ObliviousGmn/VoronUsers/printer_mods/bobbleheed/Magnetic_Panels/STL/Magnectic_MidMount_4mm.3mf

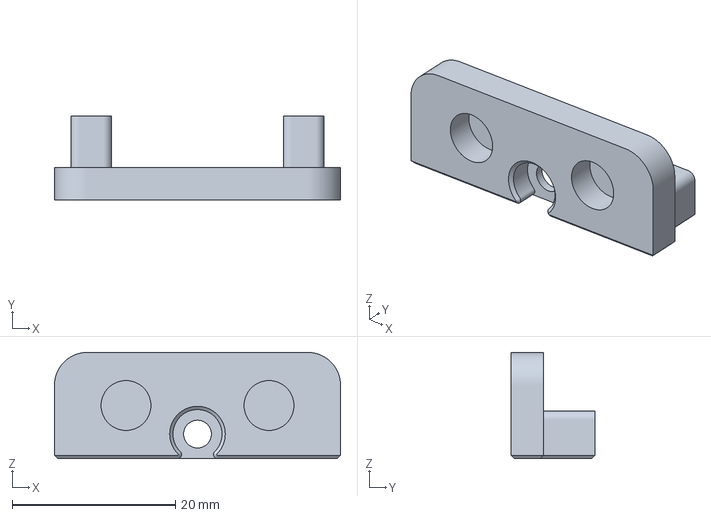
[picture p1: CAD file, 2022-02-16]
printer_mods/bobbleheed/Magnetic_Panels/STL/Magnectic_MidMount_4mm.3mf
35.0 x 10.3 x 13.0 mm
