ObliviousGmn/VoronUsers/printer_mods/Long/Mantis_Dual_5015/STLs/Ducts/1.8/Duct_v1.037_Left_+2mm.stl

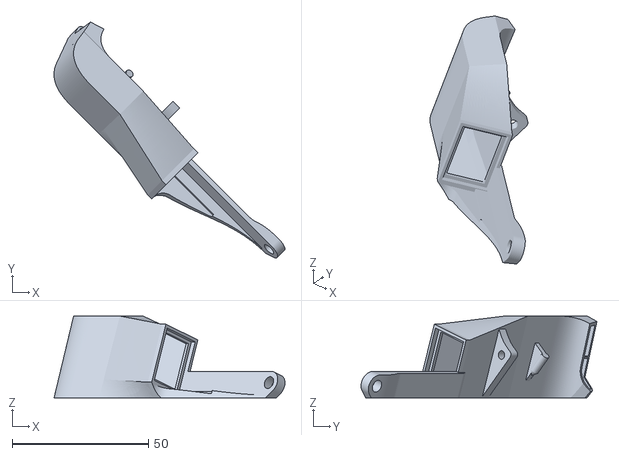
[picture p2: CAD file, 2022-02-16]
printer_mods/Long/Mantis_Dual_5015/STLs/Ducts/1.8/Duct_v1.037_Left_+2mm.stl
84.6 x 86.4 x 30.0
