ObliviousGmn/VoronUsers/printer_mods/Long/Mantis_Dual_5015/STLs/Ducts/2.4/duct_dragon_v1.041_Right.stl

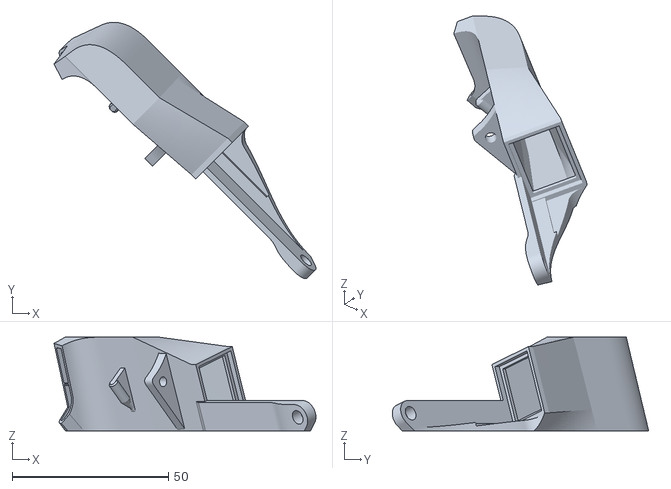
[picture p3: CAD file, 2022-02-16]
printer_mods/Long/Mantis_Dual_5015/STLs/Ducts/2.4/duct_dragon_v1.041_Right.stl
84.0 x 82.2 x 30.0
