ObliviousGmn/VoronUsers/printer_mods/Long/Mantis_Dual_5015/STLs/Hotend_Mount_Dragon_v1.040.stl

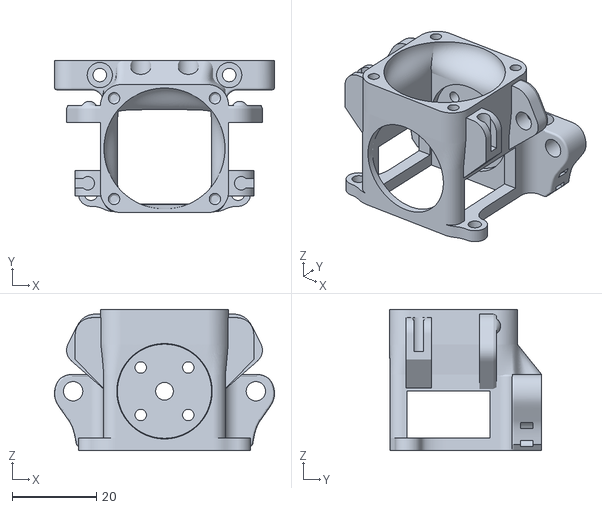
[picture p4: CAD file, 2022-02-16]
printer_mods/Long/Mantis_Dual_5015/STLs/Hotend_Mount_Dragon_v1.040.stl
52.4 x 36.2 x 33.7
