ObliviousGmn/VoronUsers/printer_mods/Long/Mantis_Dual_5015/STLs/Magprobe/Bed_Extrusion_Mount/Magprobe_Dock_Arms_v1.5.stl

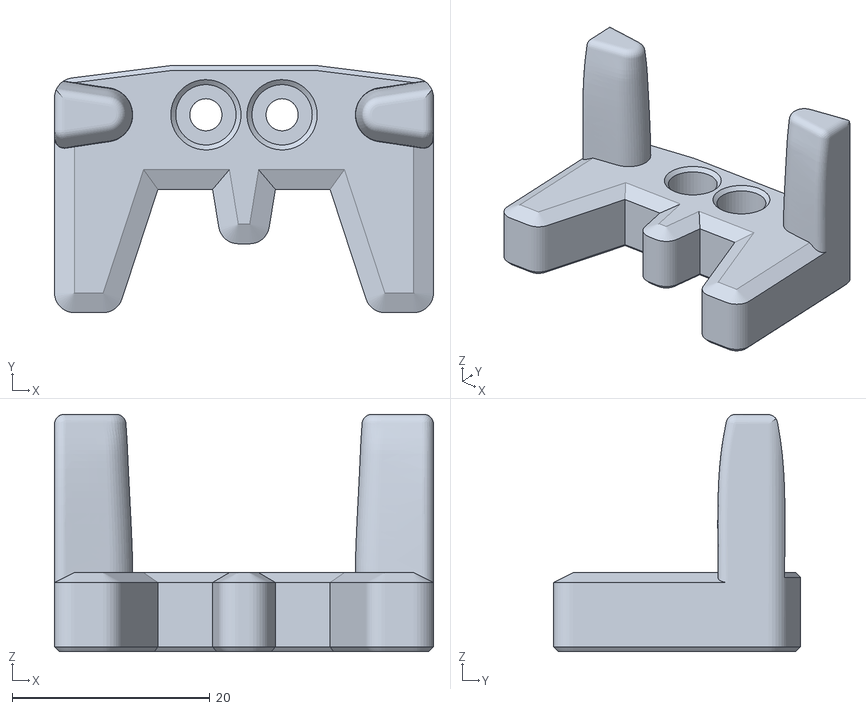
[picture p5: CAD file, 2022-02-16]
printer_mods/Long/Mantis_Dual_5015/STLs/Magprobe/Bed_Extrusion_Mount/Magprobe_Dock_Arms_v1.5.stl
38.3 x 25.0 x 24.0
