ObliviousGmn/VoronUsers/printer_mods/Long/Mantis_Dual_5015/STLs/Magprobe/Gantry_Mount/Magprobe_Gantry_Dock_Arm_v1.5_Single_magnet.stl

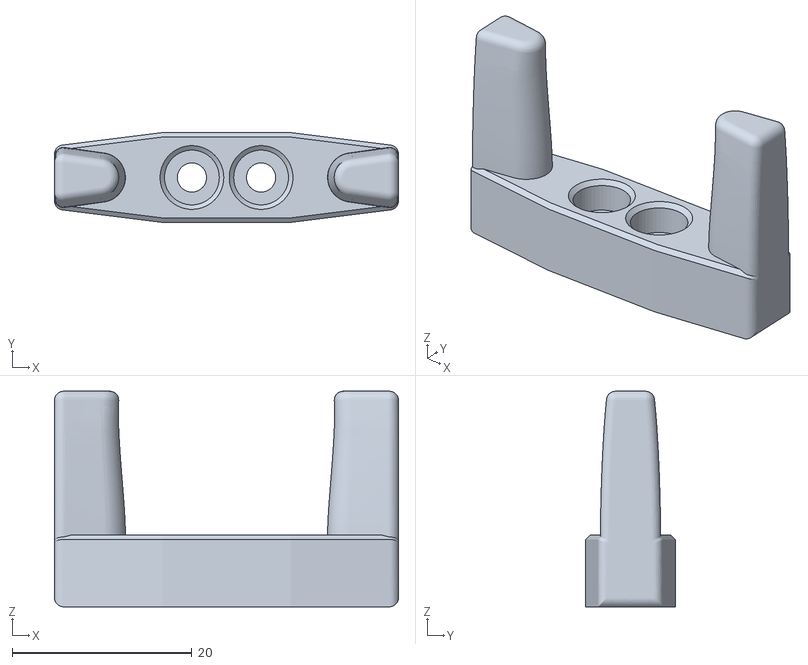
[picture p6: CAD file, 2022-02-16]
printer_mods/Long/Mantis_Dual_5015/STLs/Magprobe/Gantry_Mount/Magprobe_Gantry_Dock_Arm_v1.5_Single_magnet.stl
38.3 x 10.0 x 24.0
