ObliviousGmn/VoronUsers/printer_mods/richardjm/adxl-chain/STL/ChainAnchor-Generic-ADXL345-GY-291.stl

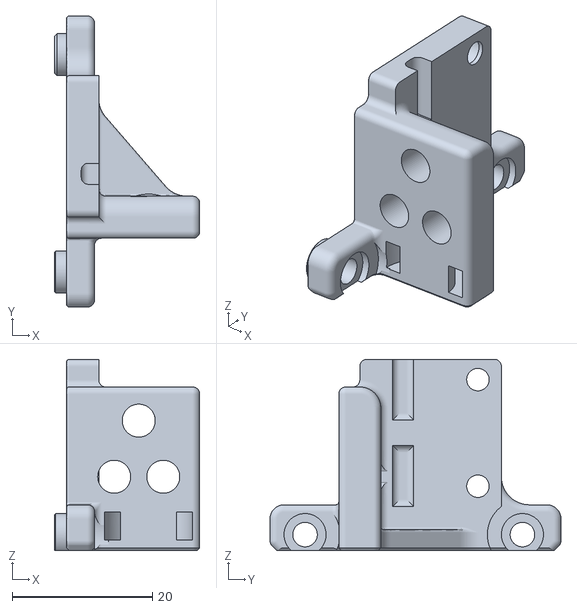
[picture p8: CAD file, 2022-02-16]
printer_mods/richardjm/adxl-chain/STL/ChainAnchor-Generic-ADXL345-GY-291.stl
20.7 x 41.5 x 27.3
