ObliviousGmn/VoronUsers/printer_mods/samwiseg0/corner_cable_hide/CAD/[a]_top_corner_cable_hide_x4.step

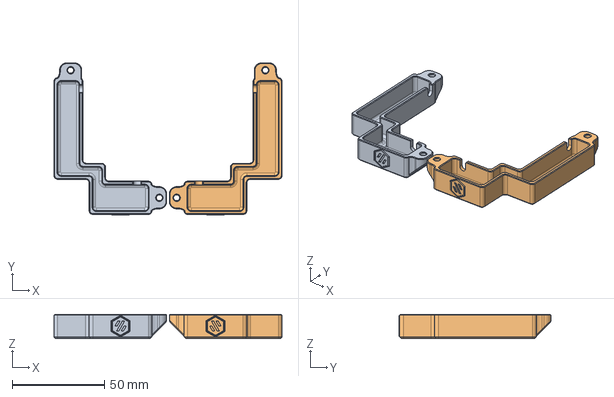
[picture p9: CAD file, 2022-02-16]
printer_mods/samwiseg0/corner_cable_hide/CAD/[a]_top_corner_cable_hide_x4.step
123.4 x 82.4 x 13.0 mm
