ObliviousGmn/VoronUsers/printer_mods/samwiseg0/corner_cable_hide/STLs/[a]_top_corner_cable_hide_right_x2.stl

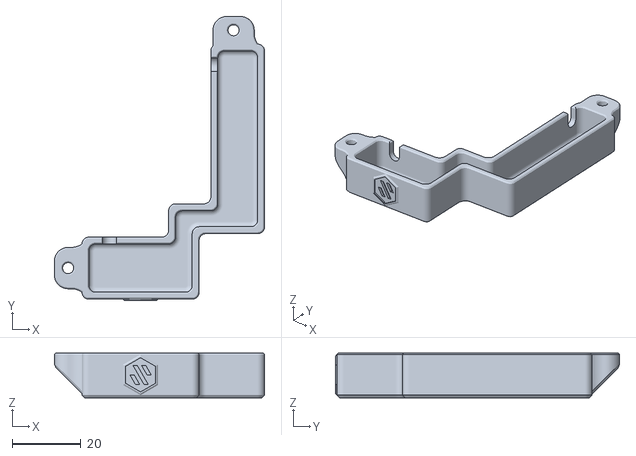
[picture p10: CAD file, 2022-02-16]
printer_mods/samwiseg0/corner_cable_hide/STLs/[a]_top_corner_cable_hide_right_x2.stl
61.0 x 82.4 x 13.0
