ObliviousGmn/VoronUsers/printer_mods/samwiseg0/esp8266_nodemcu_din_mount/CAD/esp8266_nodemcu_din_mount_universal.step

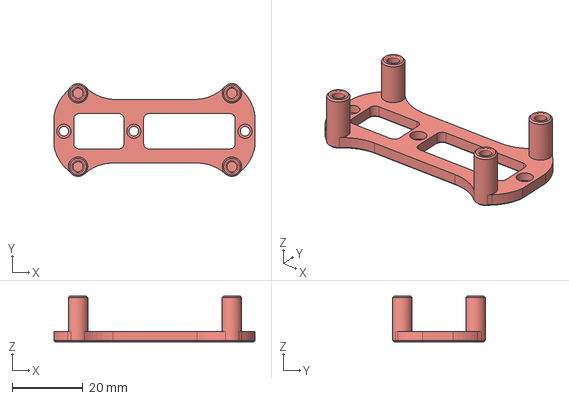
[picture p11: CAD file, 2022-02-16]
printer_mods/samwiseg0/esp8266_nodemcu_din_mount/CAD/esp8266_nodemcu_din_mount_universal.step
56.9 x 26.3 x 13.0 mm
