ObliviousGmn/VoronUsers/printer_mods/samwiseg0/extrusion_thermistor_mount/CAD/extrusion_thermistor_holder.step

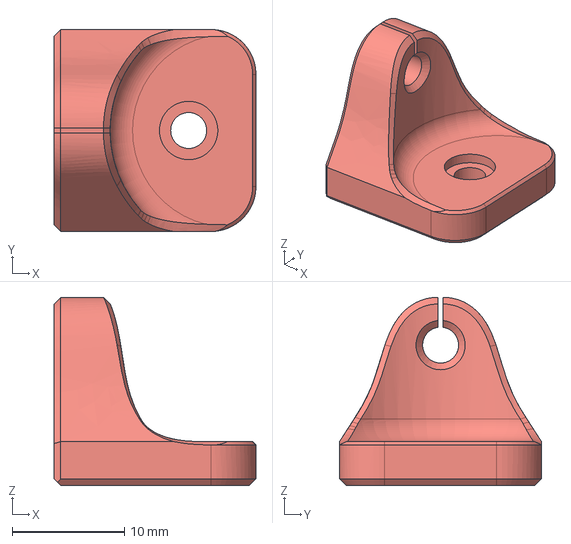
[picture p12: CAD file, 2022-02-16]
printer_mods/samwiseg0/extrusion_thermistor_mount/CAD/extrusion_thermistor_holder.step
18.0 x 18.0 x 16.8 mm
