ObliviousGmn/VoronUsers/printer_mods/samwiseg0/microfit_2x3_skirt_connector_adxl/CAD/microfit_2x3_skirt_connector_adxl.step

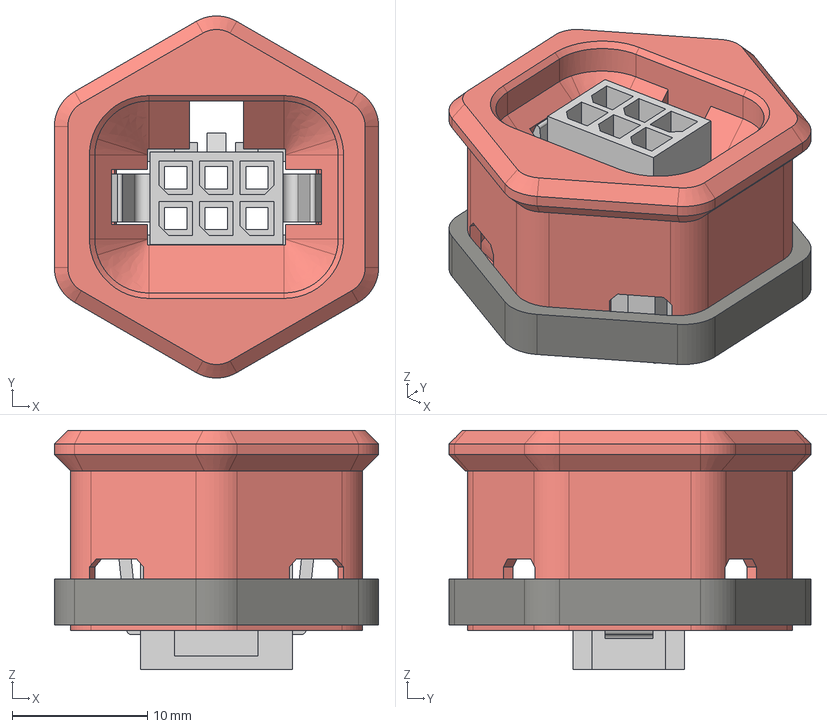
[picture p13: CAD file, 2022-02-16]
printer_mods/samwiseg0/microfit_2x3_skirt_connector_adxl/CAD/microfit_2x3_skirt_connector_adxl.step
24.0 x 26.8 x 17.7 mm
microfit_2x6_skirt_connector_adxl_base
microfit_2x6_skirt_connector_adxl_lock
430200608 v1 (1)
