ObliviousGmn/VoronUsers/printer_mods/samwiseg0/microfit_2x3_skirt_connector_adxl/STLs/[a]_microfit_2x3_skirt_connector_adxl_base.stl

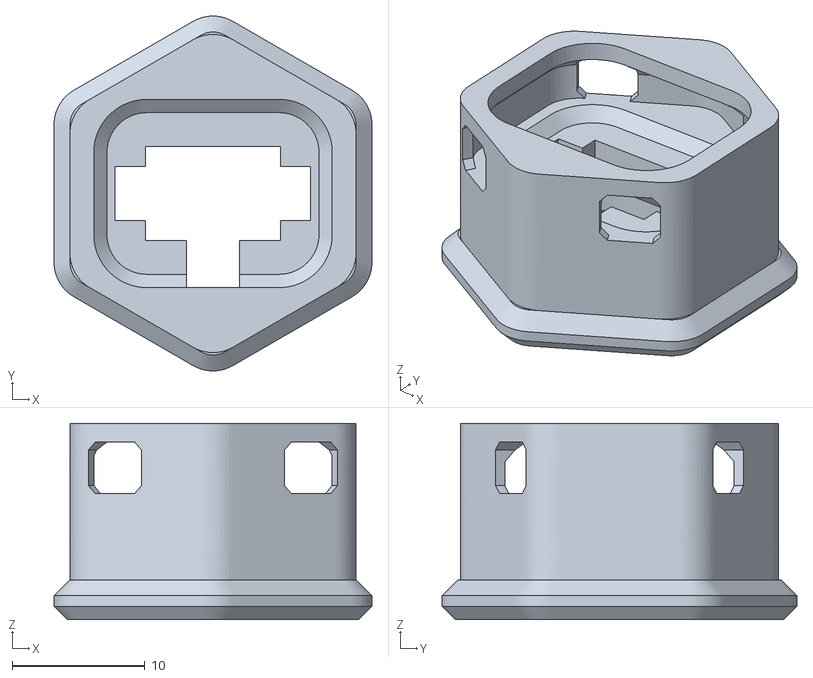
[picture p14: CAD file, 2022-02-16]
printer_mods/samwiseg0/microfit_2x3_skirt_connector_adxl/STLs/[a]_microfit_2x3_skirt_connector_adxl_base.stl
24.0 x 26.8 x 14.8
