ObliviousGmn/VoronUsers/printer_mods/samwiseg0/voyager_gtx_din_mount/CAD/voyager_gtx_din_mount_universal.step

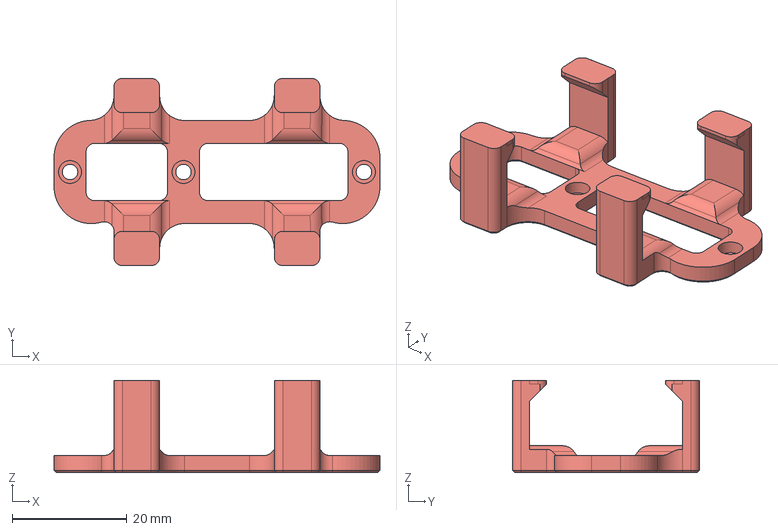
[picture p15: CAD file, 2022-02-16]
printer_mods/samwiseg0/voyager_gtx_din_mount/CAD/voyager_gtx_din_mount_universal.step
56.9 x 32.7 x 16.1 mm
