ObliviousGmn/VoronUsers/printer_mods/bobbleheed/Magnetic_Panels/STL/Magnectic_Mount_4mm.3mf

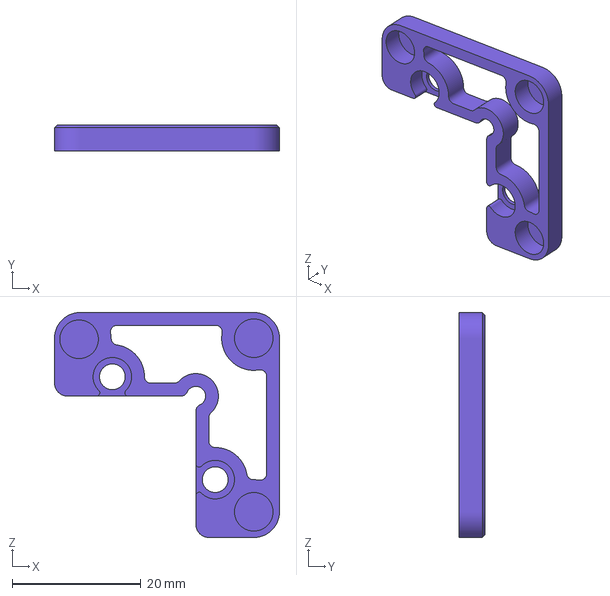
[picture p16: CAD file, 2022-01-30]
printer_mods/bobbleheed/Magnetic_Panels/STL/Magnectic_Mount_4mm.3mf
35.0 x 4.00 x 35.0 mm
