ObliviousGmn/VoronUsers/printer_mods/Long/Mantis_Dual_5015/STLs/Chain_Anchor_v3.1_IGUS.stl

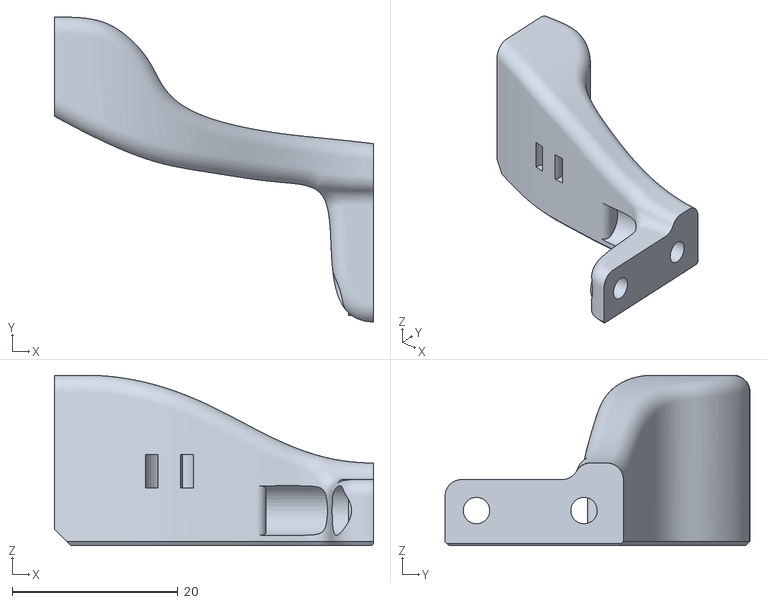
[picture p17: CAD file, 2022-02-16]
printer_mods/Long/Mantis_Dual_5015/STLs/Chain_Anchor_v3.1_IGUS.stl
38.6 x 36.9 x 20.6
