ObliviousGmn/VoronUsers/printer_mods/Long/Mantis_Dual_5015/STLs/Ducts/2.4/duct_rapido_UHF_v0.03b_left.stl

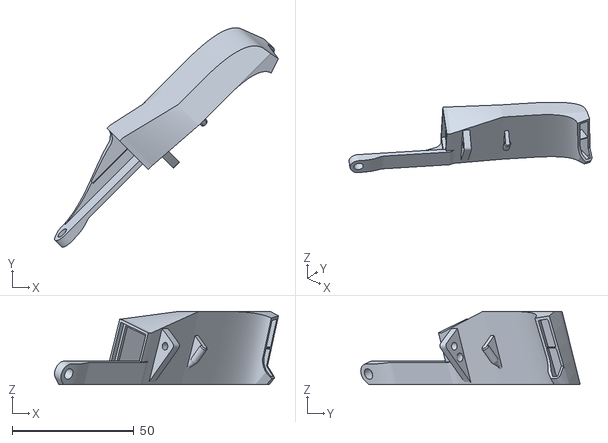
[picture p18: CAD file, 2022-02-16]
printer_mods/Long/Mantis_Dual_5015/STLs/Ducts/2.4/duct_rapido_UHF_v0.03b_left.stl
92.0 x 90.2 x 30.0
