ObliviousGmn/VoronUsers/printer_mods/Long/Mantis_Dual_5015/STLs/Magprobe/Bed_Extrusion_Mount/Magprobe_Dock_Mount_v1.0.stl

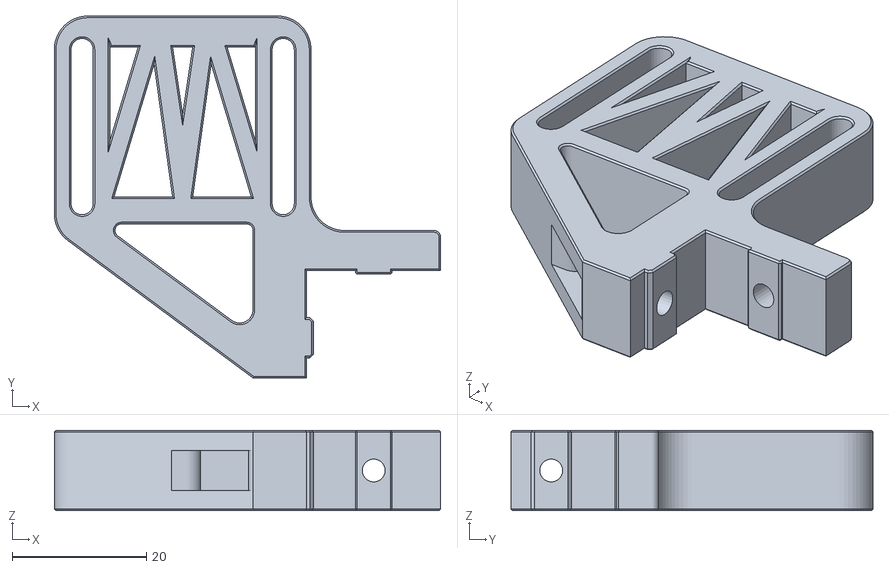
[picture p19: CAD file, 2022-02-16]
printer_mods/Long/Mantis_Dual_5015/STLs/Magprobe/Bed_Extrusion_Mount/Magprobe_Dock_Mount_v1.0.stl
57.6 x 54.0 x 12.0
