ObliviousGmn/VoronUsers/printer_mods/Long/Mantis_Dual_5015/STLs/Magprobe/Magprobe_v0.31_Dragon.stl

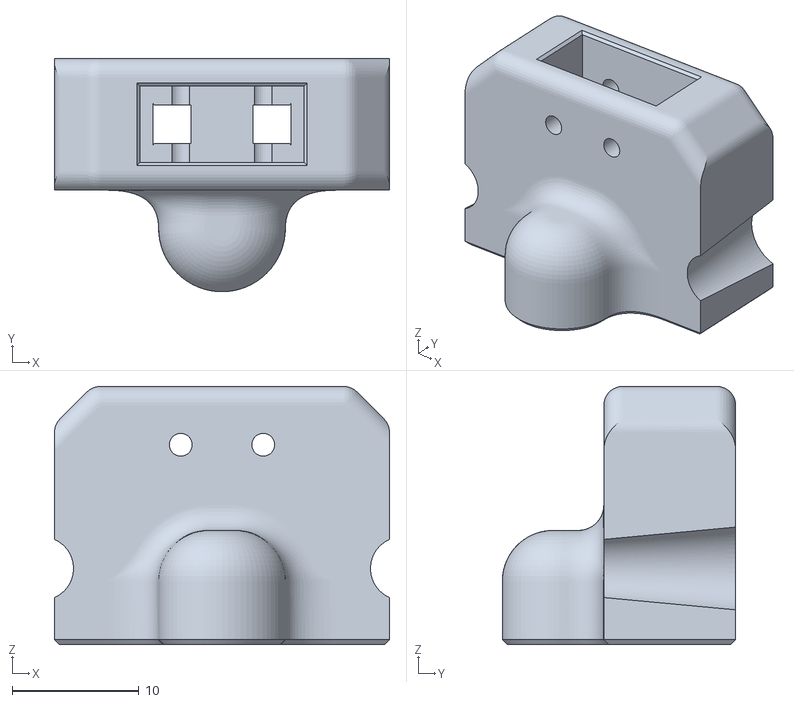
[picture p21: CAD file, 2022-02-16]
printer_mods/Long/Mantis_Dual_5015/STLs/Magprobe/Magprobe_v0.31_Dragon.stl
26.4 x 18.4 x 20.4
