ObliviousGmn/VoronUsers/printer_mods/richardjm/adxl-chain/STL/ChainAnchor-Generic-ADXL345-Adafruit.stl

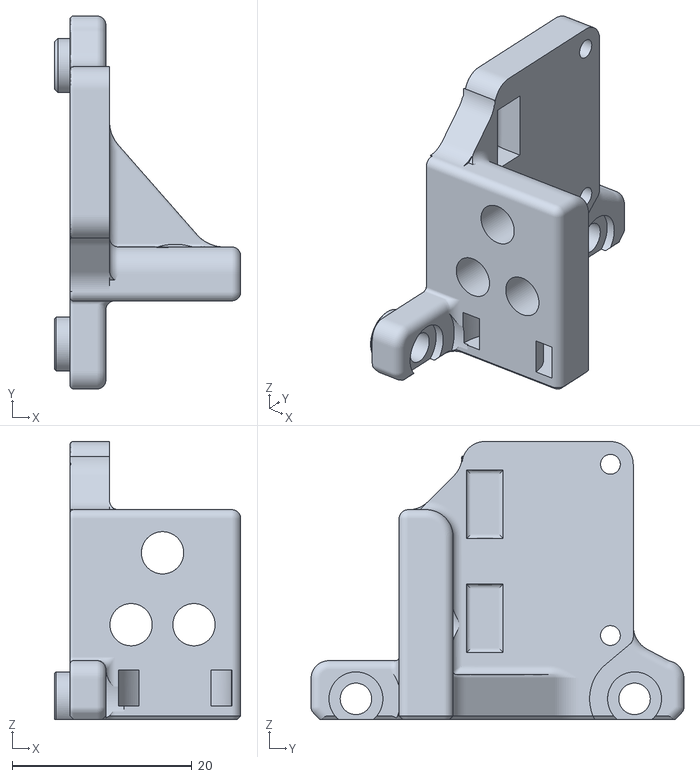
[picture p22: CAD file, 2022-02-16]
printer_mods/richardjm/adxl-chain/STL/ChainAnchor-Generic-ADXL345-Adafruit.stl
20.7 x 41.5 x 30.9
