ObliviousGmn/VoronUsers/printer_mods/samwiseg0/microfit_2x3_skirt_connector_adxl/STLs/microfit_2x3_skirt_connector_adxl_lock.stl

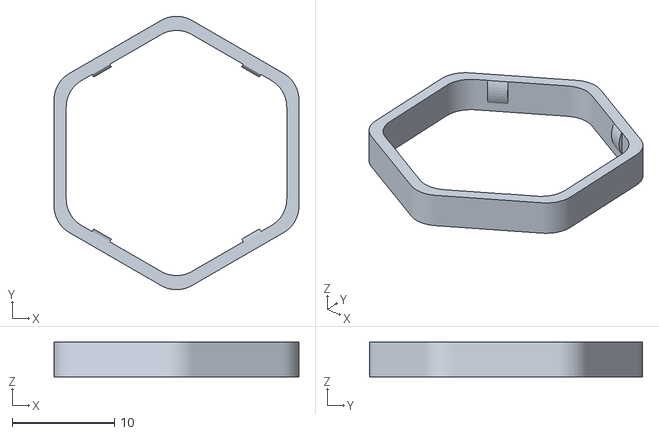
[picture p23: CAD file, 2022-02-16]
printer_mods/samwiseg0/microfit_2x3_skirt_connector_adxl/STLs/microfit_2x3_skirt_connector_adxl_lock.stl
24.0 x 26.8 x 3.40
