ObliviousGmn/VoronUsers/printer_mods/Long/Mantis_Dual_5015/STLs/Ducts/2.4/duct_rapido_HF_v0.03b_right.stl

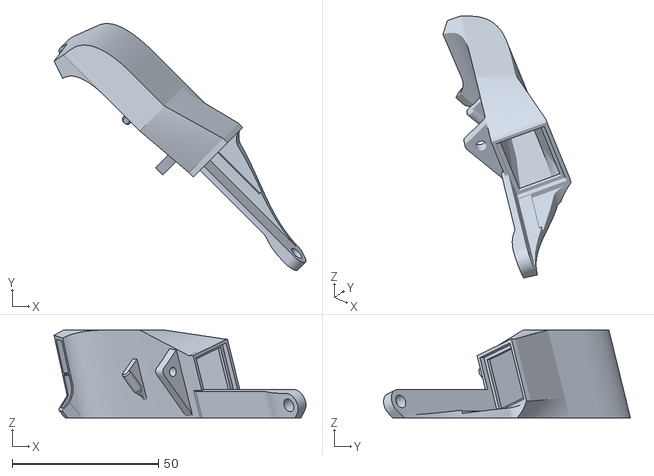
[picture p24: CAD file, 2022-02-16]
printer_mods/Long/Mantis_Dual_5015/STLs/Ducts/2.4/duct_rapido_HF_v0.03b_right.stl
86.0 x 84.3 x 30.0
