ObliviousGmn/VoronUsers/printer_mods/Long/Mantis_Dual_5015/STLs/Magprobe/Gantry_Mount/Magprobe_Gantry_Dock_Mount_by_JosAr_v1.stl

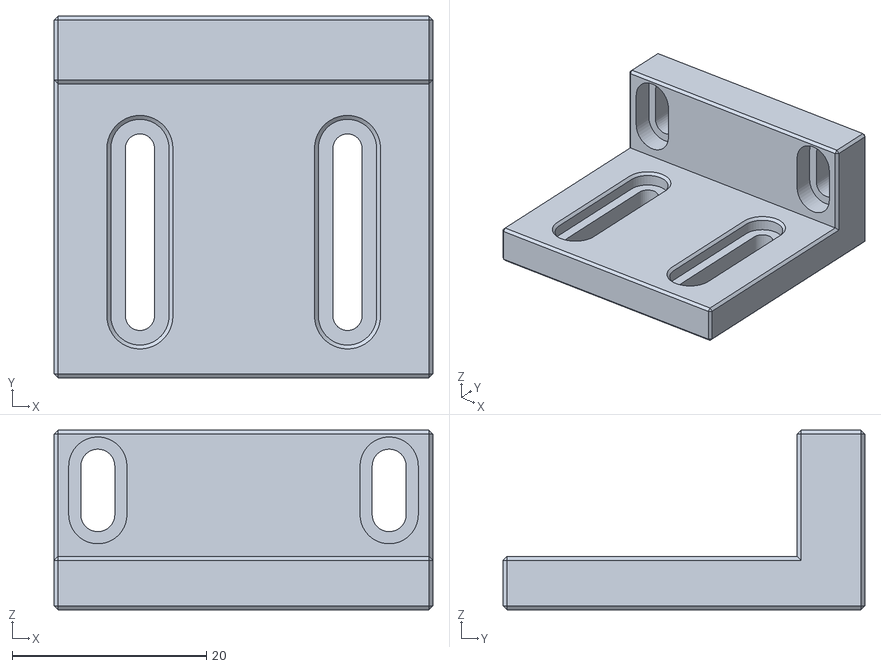
[picture p25: CAD file, 2022-02-16]
printer_mods/Long/Mantis_Dual_5015/STLs/Magprobe/Gantry_Mount/Magprobe_Gantry_Dock_Mount_by_JosAr_v1.stl
39.0 x 37.3 x 18.5
