ObliviousGmn/VoronUsers/printer_mods/Long/Mantis_Dual_5015/STLs/Magprobe/Magprobe_v0.31_RapidoHF_and_CrazyVolcano.stl

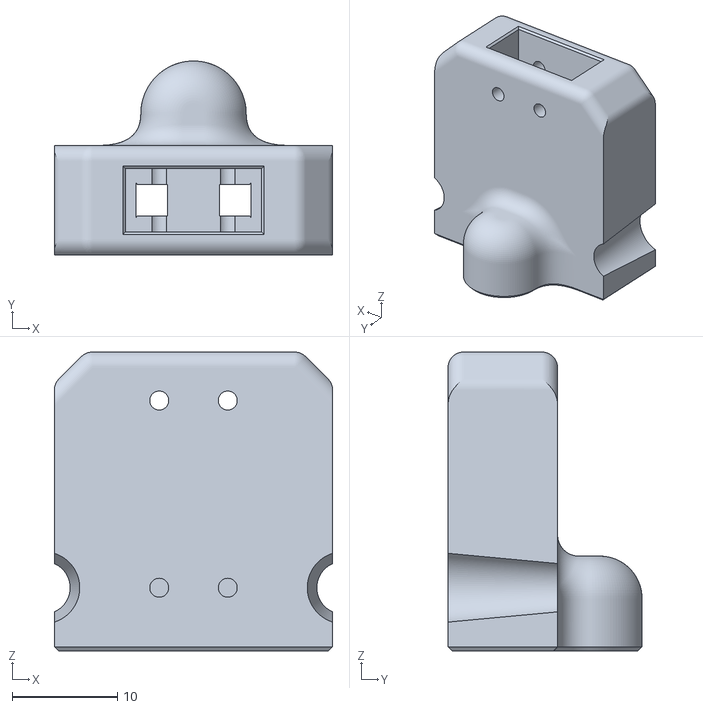
[picture p26: CAD file, 2022-02-16]
printer_mods/Long/Mantis_Dual_5015/STLs/Magprobe/Magprobe_v0.31_RapidoHF_and_CrazyVolcano.stl
26.4 x 18.4 x 28.4
