ObliviousGmn/VoronUsers/printer_mods/richardjm/adxl-chain/STL/ChainAnchor-IGUS-ADXL345-Adafruit.stl

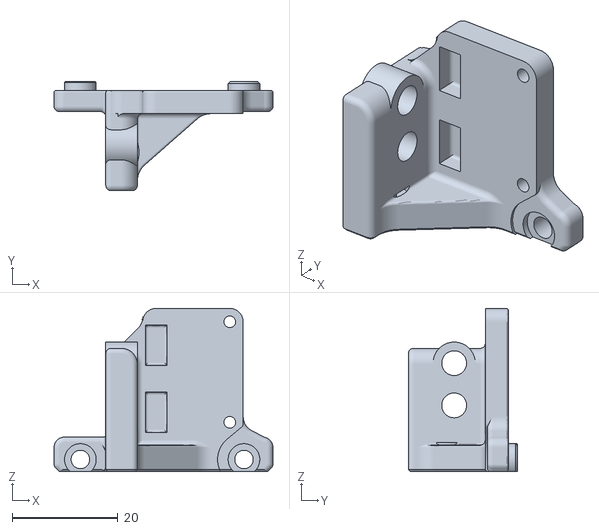
[picture p27: CAD file, 2022-02-16]
printer_mods/richardjm/adxl-chain/STL/ChainAnchor-IGUS-ADXL345-Adafruit.stl
41.5 x 20.7 x 30.9
