ObliviousGmn/VoronUsers/printer_mods/Long/Mantis_Dual_5015/STLs/Carriage_MGN9_v1.0.stl

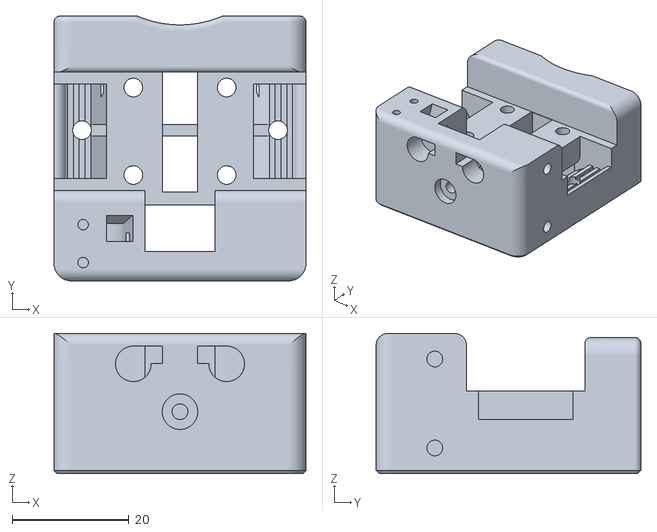
[picture p28: CAD file, 2022-02-16]
printer_mods/Long/Mantis_Dual_5015/STLs/Carriage_MGN9_v1.0.stl
43.2 x 45.4 x 24.0
