ObliviousGmn/VoronUsers/printer_mods/Long/Mantis_Dual_5015/STLs/Magprobe/Gantry_Mount/Magprobe_Gantry_Extrusion_Mount_by_JosAr_v1.stl

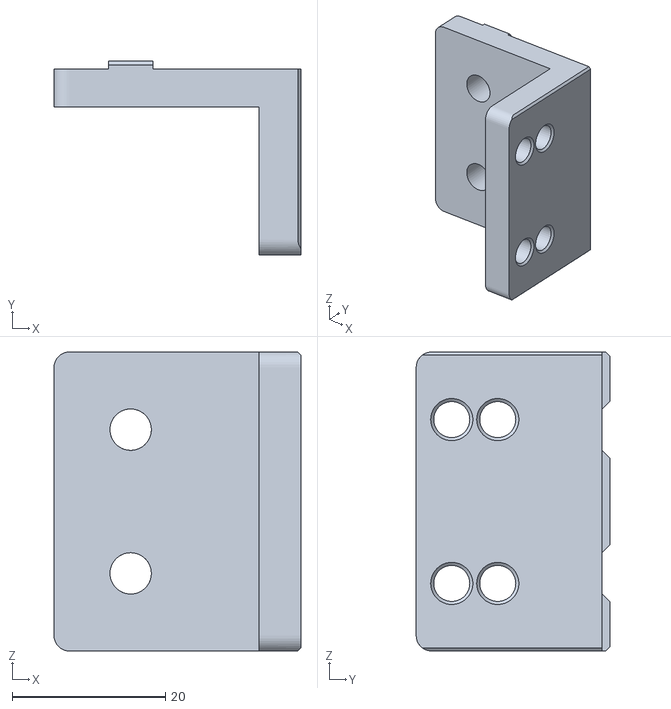
[picture p29: CAD file, 2022-02-16]
printer_mods/Long/Mantis_Dual_5015/STLs/Magprobe/Gantry_Mount/Magprobe_Gantry_Extrusion_Mount_by_JosAr_v1.stl
32.2 x 25.3 x 39.0
