ObliviousGmn/VoronUsers/printer_mods/richardjm/adxl-chain/STL/ChainAnchor-IGUS-ADXL345-GY-291.stl

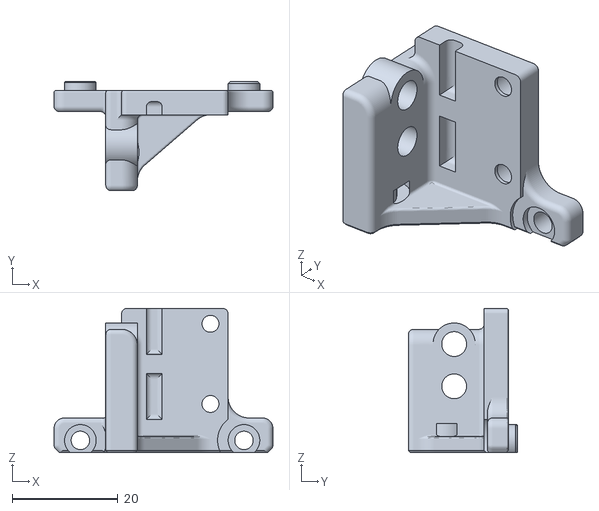
[picture p30: CAD file, 2022-02-16]
printer_mods/richardjm/adxl-chain/STL/ChainAnchor-IGUS-ADXL345-GY-291.stl
41.5 x 20.7 x 27.3
