ObliviousGmn/VoronUsers/printer_mods/Long/Mantis_Dual_5015/STLs/Umbilical_Mount_v2.stl

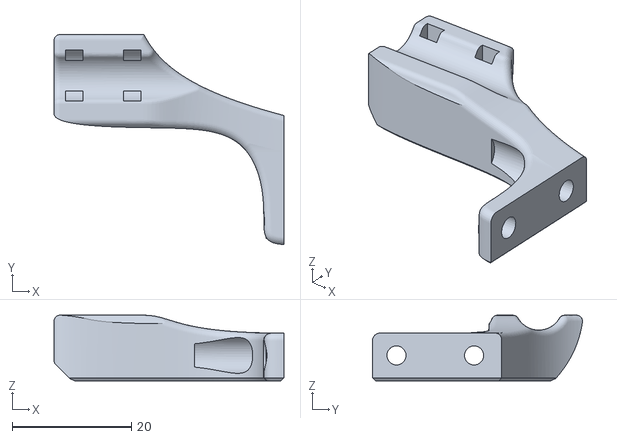
[picture p31: CAD file, 2022-02-16]
printer_mods/Long/Mantis_Dual_5015/STLs/Umbilical_Mount_v2.stl
38.6 x 35.2 x 11.0
