ObliviousGmn/VoronUsers/printer_mods/Long/Mantis_Dual_5015/STLs/Duct_Brace_v1.0.stl

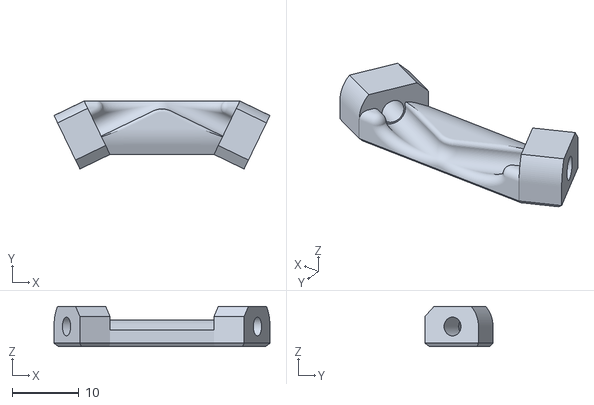
[picture p32: CAD file, 2022-02-16]
printer_mods/Long/Mantis_Dual_5015/STLs/Duct_Brace_v1.0.stl
32.3 x 10.2 x 6.00
