ObliviousGmn/VoronUsers/printer_mods/Long/Mantis_Dual_5015/STLs/Chain_Anchor_v3.2.stl

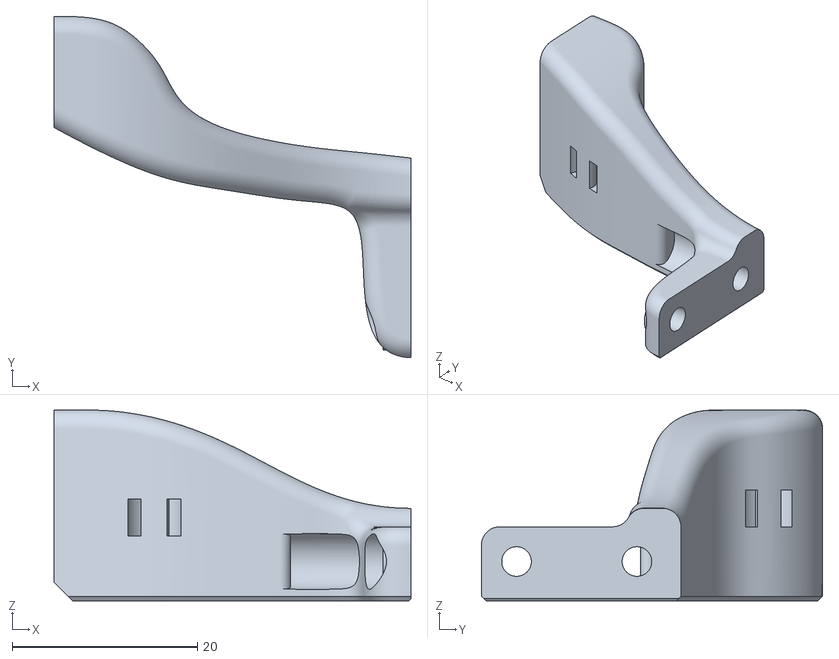
[picture p33: CAD file, 2022-02-16]
printer_mods/Long/Mantis_Dual_5015/STLs/Chain_Anchor_v3.2.stl
38.6 x 36.8 x 20.6
