ObliviousGmn/VoronUsers/printer_mods/Long/Mantis_Dual_5015/STLs/Carriage_MGN12_v1.040.stl

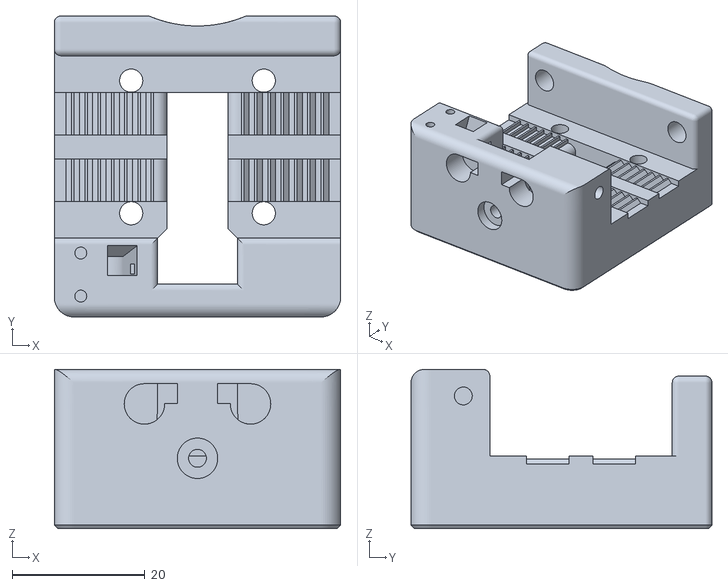
[picture p34: CAD file, 2022-02-16]
printer_mods/Long/Mantis_Dual_5015/STLs/Carriage_MGN12_v1.040.stl
43.2 x 45.4 x 24.0
