ObliviousGmn/VoronUsers/(list of files, cad)

Other CAD files:
printer_mods/samwiseg0/extrusion_thermistor_mount/STLs/[a]_extrusion_thermistor_mount.stl
printer_mods/Long/Mantis_Dual_5015/STLs/Ducts/1.8/Duct_v1.037_Right_+2mm.stl
printer_mods/samwiseg0/corner_cable_hide/STLs/[a]_top_corner_cable_hide_left_x2.stl
printer_mods/Long/Mantis_Dual_5015/STLs/Hotend_Mount_Rapido_v.03.stl
printer_mods/Long/Mantis_Dual_5015/STLs/Ducts/2.4/duct_rapido_UHF_v0.03b_right.stl
printer_mods/Long/Mantis_Dual_5015/STLs/Ducts/2.4/duct_dragon_v1.041_Left.stl
printer_mods/Long/Mantis_Dual_5015/STLs/Ducts/2.4/duct_dragon_crazy_volcano_v1.0_left.stl
printer_mods/Long/Mantis_Dual_5015/STLs/Ducts/2.4/duct_dragon_crazy_volcano_v1.0_right.stl
printer_mods/Long/Mantis_Dual_5015/STLs/Ducts/2.4/duct_rapido_HF_v0.03b_left.stl
printer_mods/Long/Mantis_Dual_5015/STLs/Hotend_Mount_Rapido_v.03_Rotated120Degrees.stl
printer_mods/richardjm/adxl-chain/CAD/ADXL345-Carriage-Adafruit-v45.f3d
printer_mods/richardjm/adxl-chain/CAD/ADXL345-Carriage-GY-291-v3.f3d
printer_mods/samwiseg0/esp8266_nodemcu_din_mount/STLs/esp8266_nodemcu_din_mount_universal.stl
printer_mods/samwiseg0/voyager_gtx_din_mount/STLs/voyager_gtx_din_mount_universal.stl
