ObliviousGmn/VoronUsers/printer_mods/Long/Mantis_Dual_5015/images/carriage_assembly_heatsets.jpg

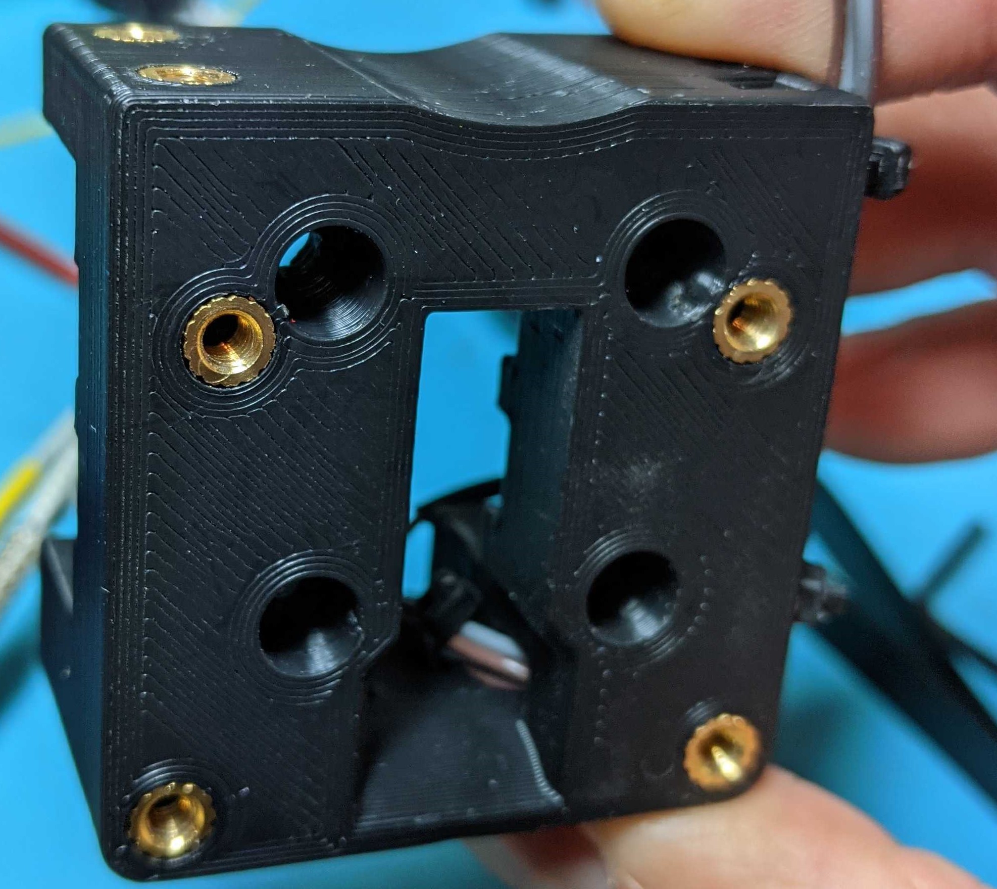
printer_mods/Long/Mantis_Dual_5015/images/carriage_assembly_heatsets.jpg
