ObliviousGmn/VoronUsers/printer_mods/Long/Mantis_Dual_5015/images/hotends_rapdio_cad.png

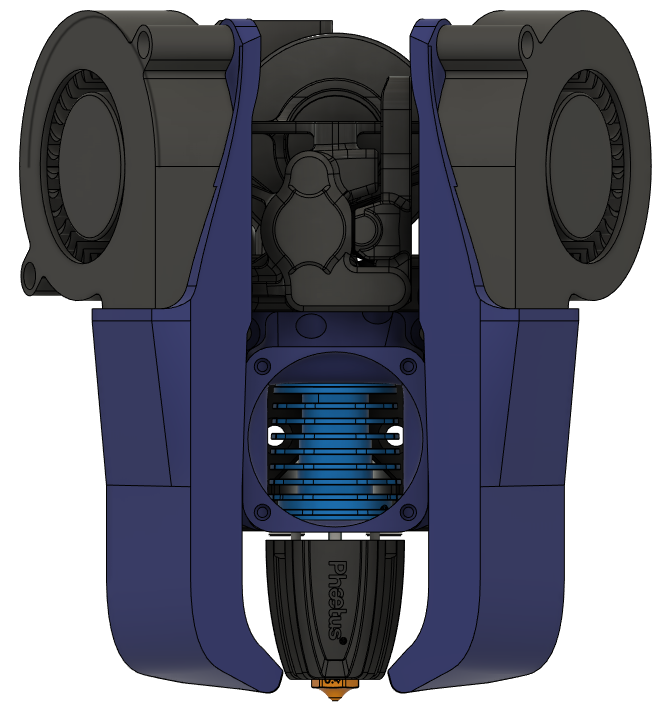
printer_mods/Long/Mantis_Dual_5015/images/hotends_rapdio_cad.png
